bodgit/bkm-129x-ultimate/main/main.kicad_pcb

## KiCad design main/main.kicad_pcb (2022-10-09)

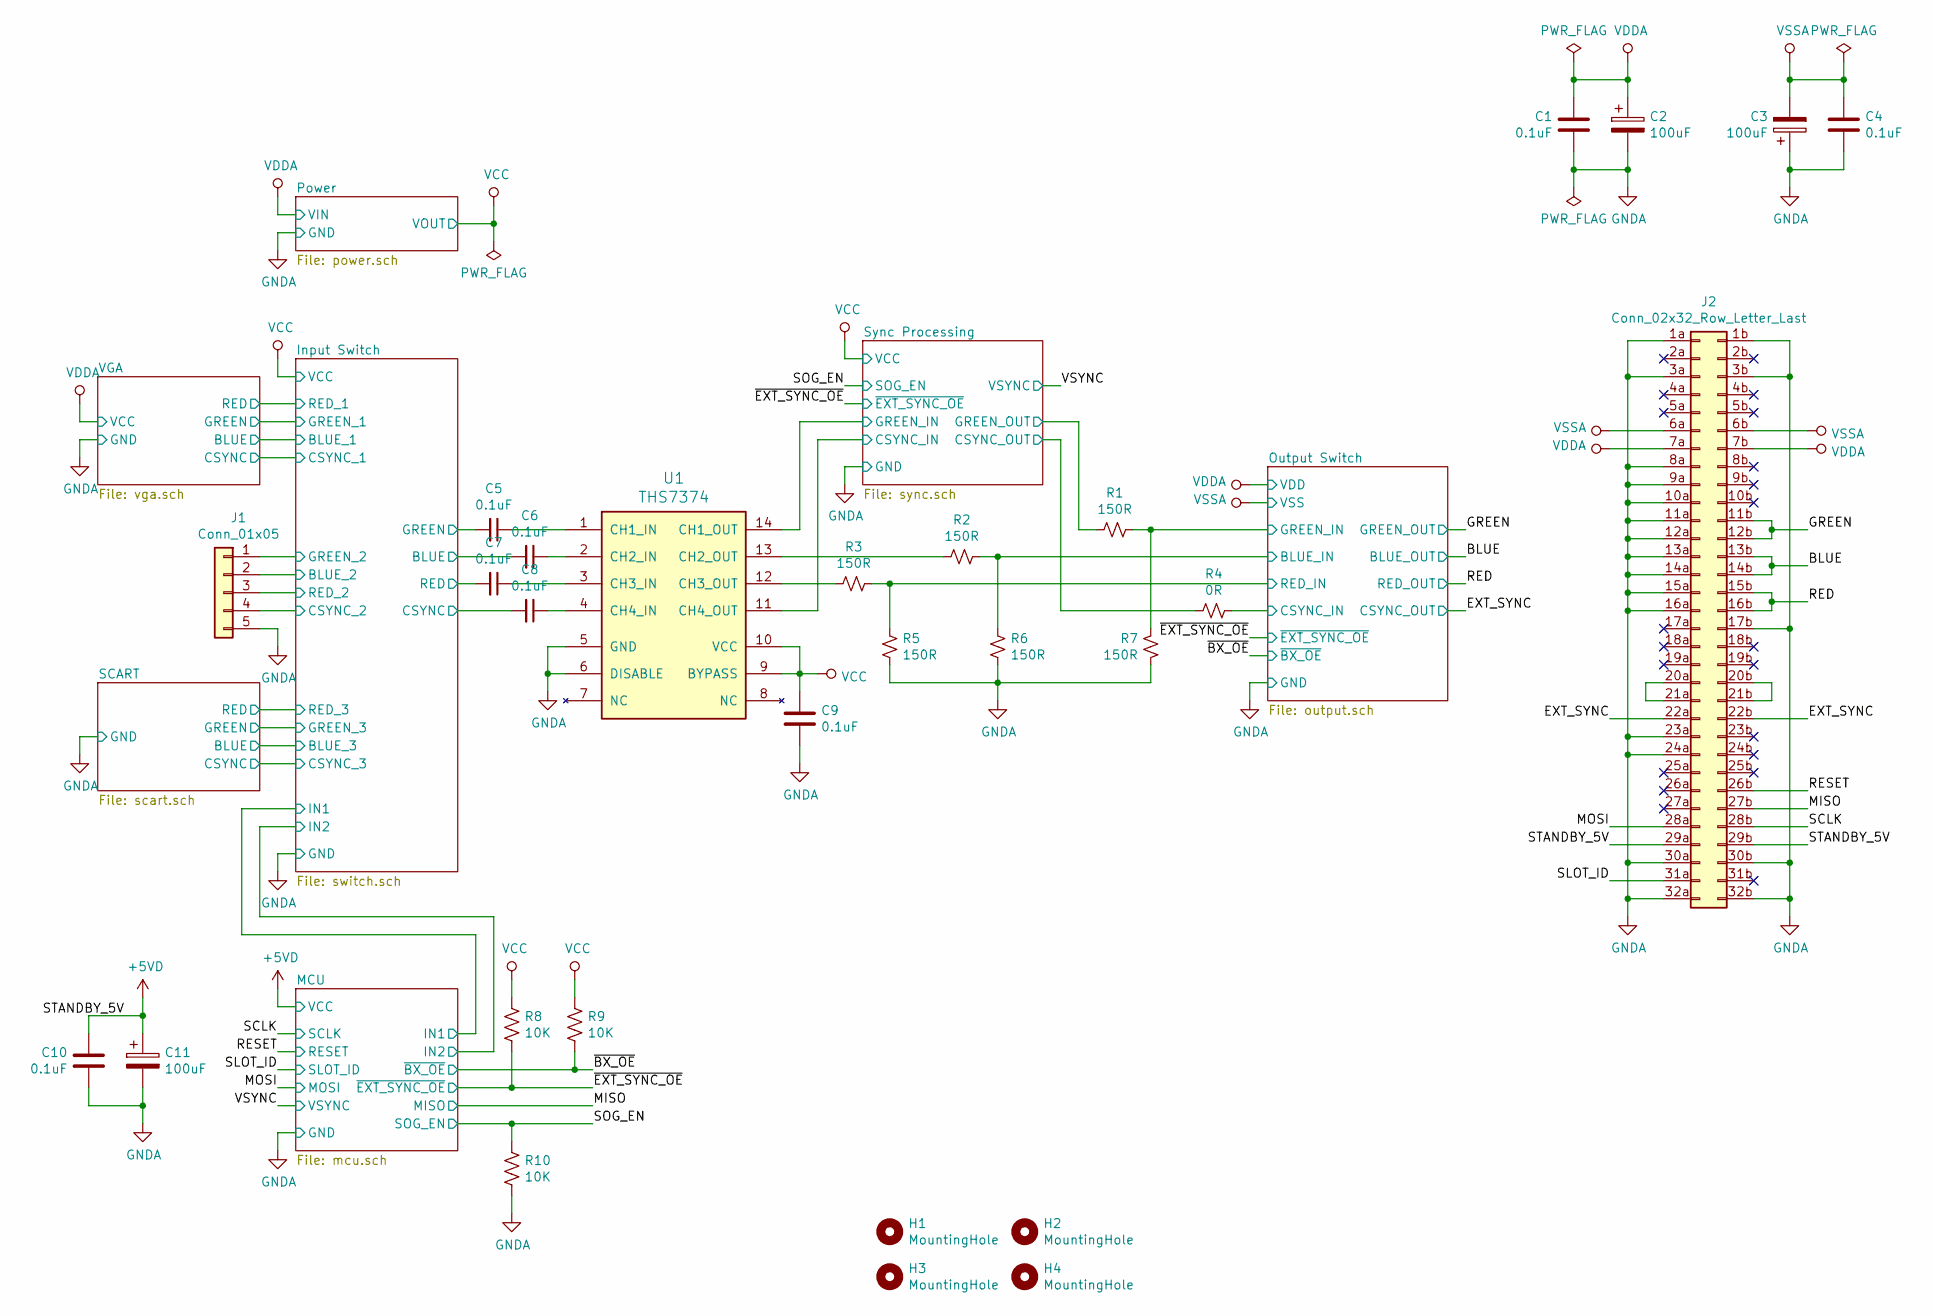
[picture p1: schematic main.sch]

Parts:
C1, C4, C5, C6, C7, C8, C9, C10: 0.1uF; C_0805_2012Metric_Pad1.15x1.40mm_HandSolder
C2, C3, C11: 100uF; CP_Elec_6.3x5.3
H1, H2, H3, H4: MountingHole; MountingHole_3.2mm_M3
J1: Conn_01x05; JST_NH_BS5P-SHF-1AA_1x05_P2.50mm_Horizontal
J2: Conn_02x32_Row_Letter_Last; STANDARD-PIN-64P-RA
R1, R2, R3, R5, R6, R7: 150R; R_0805_2012Metric_Pad1.15x1.40mm_HandSolder
R4: 0R; R_0805_2012Metric_Pad1.15x1.40mm_HandSolder
R8, R9, R10: 10K; R_0805_2012Metric_Pad1.15x1.40mm_HandSolder
U1: THS7374; TSSOP-14_4.4x5mm_P0.65mm

Connections:
+5VD: C10.1, C11.1, J2.29a, J2.29b; also elsewhere on the board
/BLUE: J2.13b, J2.14b; also elsewhere on the board
/EXT_SYNC: J2.22a, J2.22b; also elsewhere on the board
/GREEN: J2.11b, J2.12b; also elsewhere on the board
/Input Switch/BLUE: C6.2; also elsewhere on the board
/Input Switch/BLUE_2: J1.2; also elsewhere on the board
/Input Switch/CSYNC: C8.2; also elsewhere on the board
/Input Switch/CSYNC_2: J1.4; also elsewhere on the board
/Input Switch/GREEN: C5.2; also elsewhere on the board
/Input Switch/GREEN_2: J1.1; also elsewhere on the board
/Input Switch/RED: C7.2; also elsewhere on the board
/Input Switch/RED_2: J1.3; also elsewhere on the board
/MISO: J2.27b; also elsewhere on the board
/MOSI: J2.28a; also elsewhere on the board
/Output Switch/BLUE_IN: R2.1, R6.2; also elsewhere on the board
/Output Switch/CSYNC_IN: R4.1; also elsewhere on the board
/Output Switch/GREEN_IN: R1.1, R7.2; also elsewhere on the board
/Output Switch/RED_IN: R3.1, R5.2; also elsewhere on the board
/RED: J2.15b, J2.16b; also elsewhere on the board
/RESET: J2.26b; also elsewhere on the board
/SCLK: J2.28b; also elsewhere on the board
/SLOT_ID: J2.31a; also elsewhere on the board
/SOG_EN: R10.1; also elsewhere on the board
/Sync Processing/CSYNC_IN: U1.11 (CH4_OUT); also elsewhere on the board
/Sync Processing/CSYNC_OUT: R4.2; also elsewhere on the board
/Sync Processing/GREEN_IN: U1.14 (CH1_OUT); also elsewhere on the board
/Sync Processing/GREEN_OUT: R1.2; also elsewhere on the board
/~BX_OE: R9.2; also elsewhere on the board
/~EXT_SYNC_OE: R8.2; also elsewhere on the board
GND: C1.2, C2.2, C3.1, C4.2, C9.2, C10.2, C11.2, J1.5, J2.1a, J2.1b, J2.3a, J2.3b, J2.8a, J2.9a, J2.10a, J2.11a, J2.12a, J2.13a, J2.14a, J2.15a, J2.16a, J2.17b, J2.23a, J2.24a, J2.30a, J2.30b, J2.32a, J2.32b, R5.1, R6.1, R7.1, R10.2, U1.5 (GND), U1.6 (DISABLE); also elsewhere on the board
unnamed: C5.1, U1.1 (CH1_IN)
unnamed: C6.1, U1.2 (CH2_IN)
unnamed: C7.1, U1.3 (CH3_IN)
unnamed: C8.1, U1.4 (CH4_IN)
unnamed: J2.20a, J2.21a
unnamed: J2.20b, J2.21b
unnamed: R2.2, U1.13 (CH2_OUT)
unnamed: R3.2, U1.12 (CH3_OUT)
VCC: C9.1, R8.1, R9.1, U1.9 (BYPASS), U1.10 (VCC); also elsewhere on the board
VDDA: C1.1, C2.1, J2.7a, J2.7b; also elsewhere on the board
VSSA: C3.2, C4.1, J2.6a, J2.6b; also elsewhere on the board

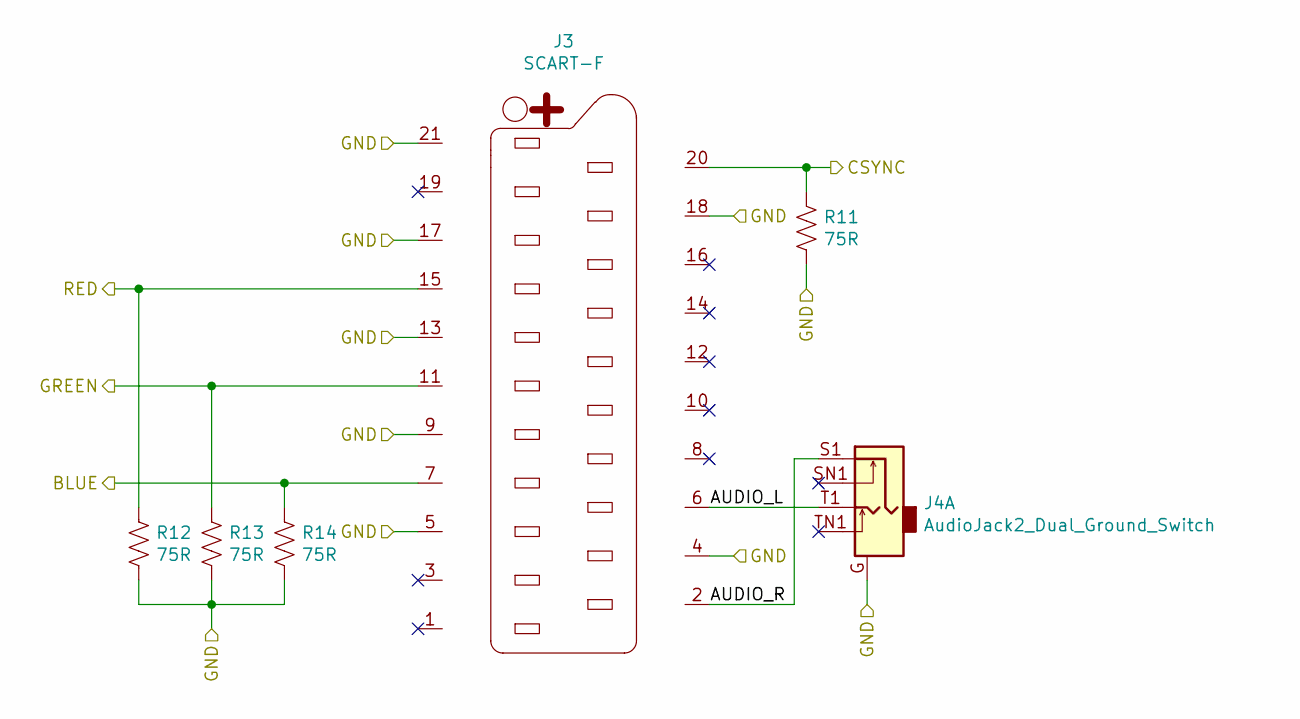
[picture p2: schematic scart.sch]

Parts:
J3: SCART-F; NINIGI-SCART-RA
J4: AudioJack2_Dual_Ground_Switch; SJ1-353XNG
R11, R12, R13, R14: 75R; R_0805_2012Metric_Pad1.15x1.40mm_HandSolder

Connections:
/SCART/AUDIO_L: J3.6, J4.T1
/SCART/AUDIO_R: J3.2, J4.S1
/SCART/BLUE: J3.7, R14.1; also elsewhere on the board
/SCART/CSYNC: J3.20, R11.1; also elsewhere on the board
/SCART/GREEN: J3.11, R13.1; also elsewhere on the board
/SCART/RED: J3.15, R12.1; also elsewhere on the board
GND: J3.4, J3.5, J3.9, J3.13, J3.17, J3.18, J3.21, J4.G, R11.2, R12.2, R13.2, R14.2; also elsewhere on the board

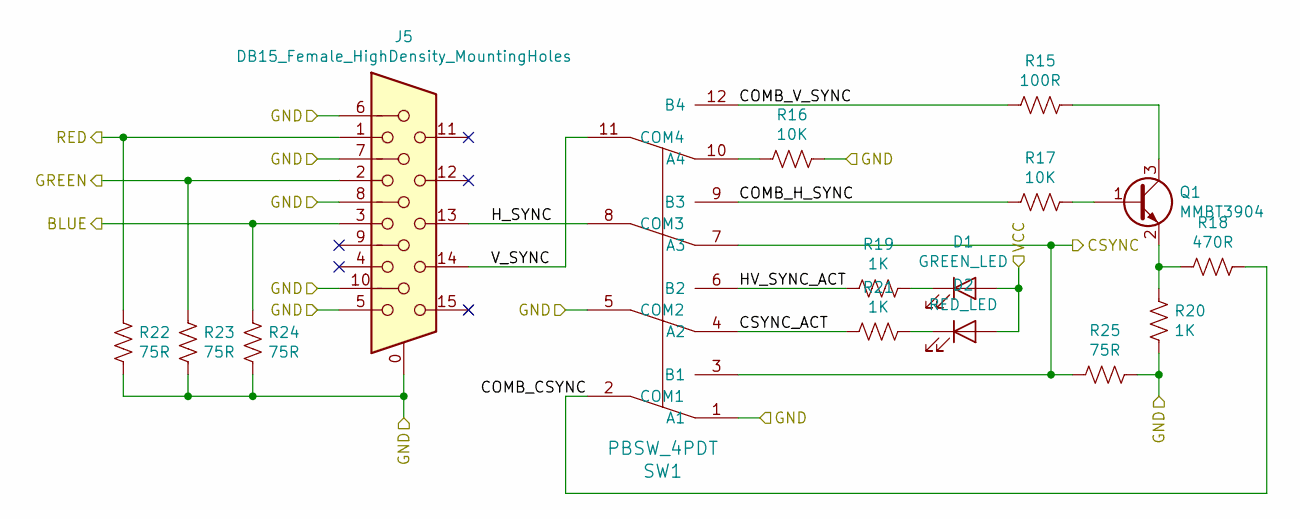
[picture p3: schematic vga.sch]

Parts:
D1: GREEN_LED; D_0805_2012Metric_Pad1.15x1.40mm_HandSolder
D2: RED_LED; D_0805_2012Metric_Pad1.15x1.40mm_HandSolder
J5: DB15_Female_HighDensity_MountingHoles; HD15-VGA
Q1: MMBT3904; SOT-23_Handsoldering
R15: 100R; R_0805_2012Metric_Pad1.15x1.40mm_HandSolder
R16, R17: 10K; R_0805_2012Metric_Pad1.15x1.40mm_HandSolder
R18: 470R; R_0805_2012Metric_Pad1.15x1.40mm_HandSolder
R19, R20, R21: 1K; R_0805_2012Metric_Pad1.15x1.40mm_HandSolder
R22, R23, R24, R25: 75R; R_0805_2012Metric_Pad1.15x1.40mm_HandSolder
SW1: PBSW_4PDT; PBH4U

Connections:
/VGA/BLUE: J5.3, R24.1; also elsewhere on the board
/VGA/COMB_CSYNC: R18.1, SW1.2 (COM1)
/VGA/COMB_H_SYNC: R17.2, SW1.9 (B3)
/VGA/COMB_V_SYNC: R15.2, SW1.12 (B4)
/VGA/CSYNC: R25.2, SW1.3 (B1), SW1.7 (A3); also elsewhere on the board
/VGA/CSYNC_ACT: R21.2, SW1.4 (A2)
/VGA/GREEN: J5.2, R23.1; also elsewhere on the board
/VGA/HV_SYNC_ACT: R19.2, SW1.6 (B2)
/VGA/H_SYNC: J5.13, SW1.8 (COM3)
/VGA/RED: J5.1, R22.1; also elsewhere on the board
/VGA/V_SYNC: J5.14, SW1.11 (COM4)
GND: J5.0, J5.5, J5.6, J5.7, J5.8, J5.10, R16.2, R20.2, R22.2, R23.2, R24.2, R25.1, SW1.1 (A1), SW1.5 (COM2); also elsewhere on the board
unnamed: D1.1 (K), R19.1
unnamed: D2.1 (K), R21.1
unnamed: Q1.1 (B), R17.1
unnamed: Q1.2 (E), R18.2, R20.1
unnamed: Q1.3 (C), R15.1
unnamed: R16.1, SW1.10 (A4)
VDDA: D1.2 (A), D2.2 (A); also elsewhere on the board

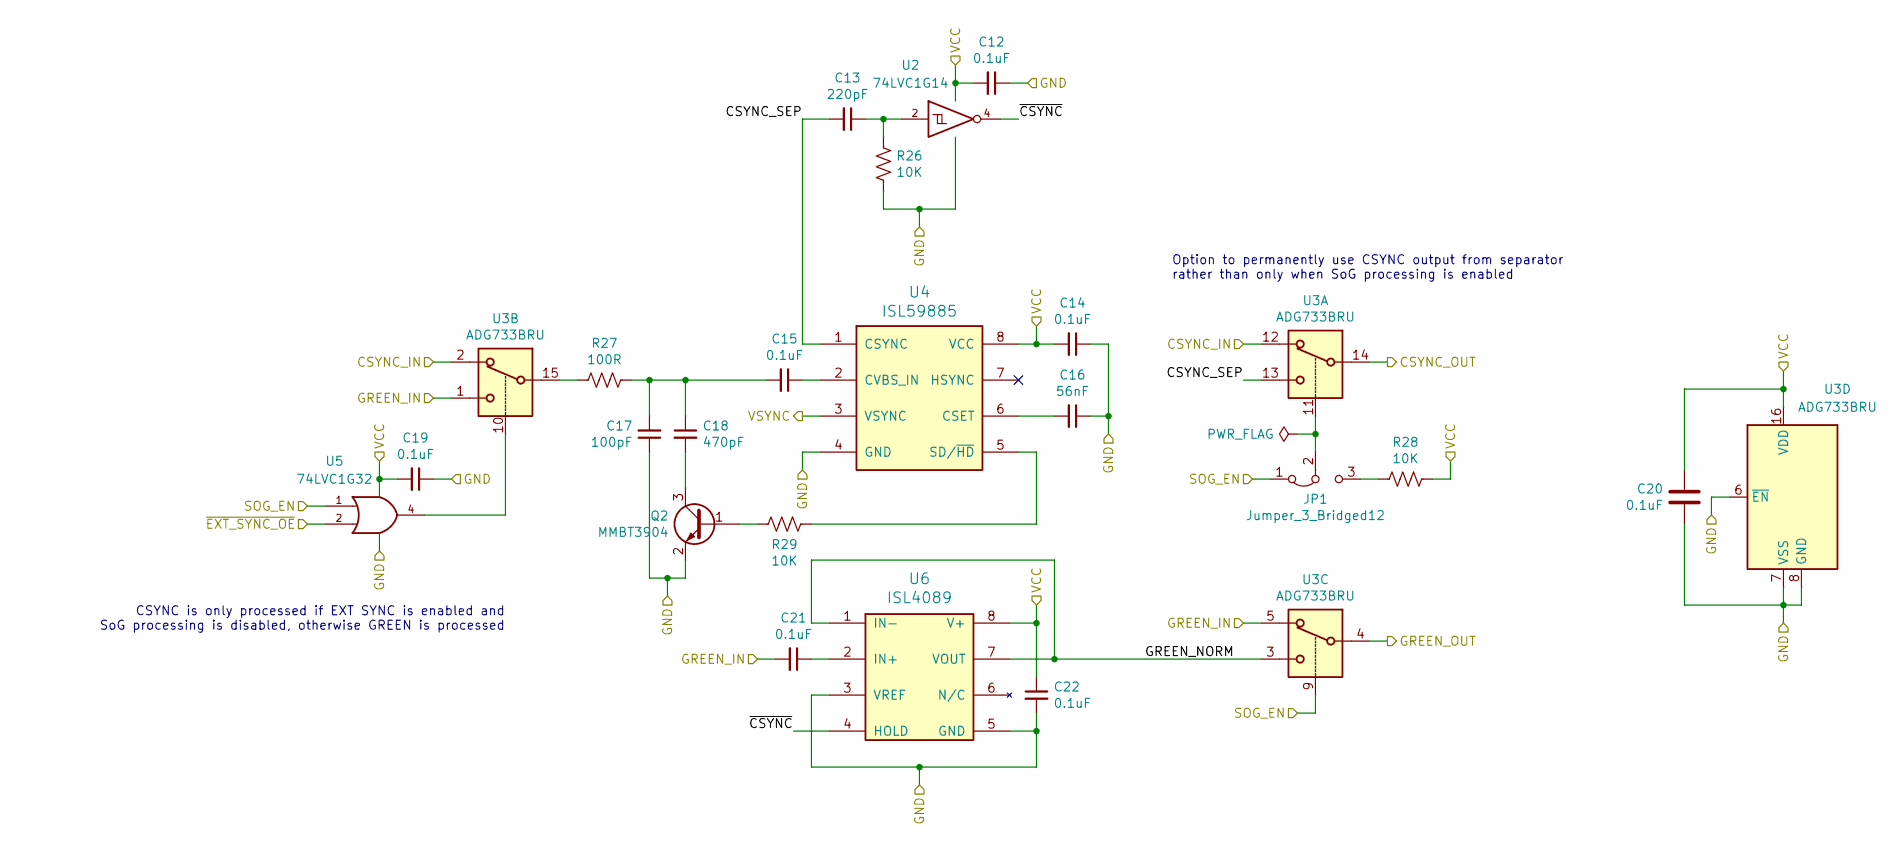
[picture p4: schematic sync.sch]

Parts:
C12, C14, C15, C19, C20, C21, C22: 0.1uF; C_0805_2012Metric_Pad1.15x1.40mm_HandSolder
C13: 220pF; C_0805_2012Metric_Pad1.15x1.40mm_HandSolder
C16: 56nF; C_0805_2012Metric_Pad1.15x1.40mm_HandSolder
C17: 100pF; C_0805_2012Metric_Pad1.15x1.40mm_HandSolder
C18: 470pF; C_0805_2012Metric_Pad1.15x1.40mm_HandSolder
JP1: Jumper_3_Bridged12; PinHeader_1x03_P2.54mm_Vertical
Q2: MMBT3904; SOT-23_Handsoldering
R26, R28, R29: 10K; R_0805_2012Metric_Pad1.15x1.40mm_HandSolder
R27: 100R; R_0805_2012Metric_Pad1.15x1.40mm_HandSolder
U2: 74LVC1G14; SOT-23-5_HandSoldering
U3: ADG733BRU; TSSOP-16_4.4x5mm_P0.65mm
U4: ISL59885; SOIC-8_3.9x4.9mm_P1.27mm
U5: 74LVC1G32; SOT-23-5_HandSoldering
U6: ISL4089; SOIC-8_3.9x4.9mm_P1.27mm

Connections:
/SOG_EN: JP1.1 (A), U3.9, U5.1; also elsewhere on the board
/Sync Processing/CSYNC_IN: U3.2, U3.12; also elsewhere on the board
/Sync Processing/CSYNC_OUT: U3.14; also elsewhere on the board
/Sync Processing/CSYNC_SEP: C13.2, U3.13, U4.1 (CSYNC)
/Sync Processing/GREEN_IN: C21.2, U3.1, U3.5; also elsewhere on the board
/Sync Processing/GREEN_NORM: U3.3, U6.1 (IN-), U6.7 (VOUT)
/Sync Processing/GREEN_OUT: U3.4; also elsewhere on the board
/Sync Processing/~CSYNC: U2.4, U6.4 (HOLD)
/VSYNC: U4.3 (VSYNC); also elsewhere on the board
/~EXT_SYNC_OE: U5.2; also elsewhere on the board
GND: C12.1, C14.1, C16.1, C17.1, C19.1, C20.2, C22.2, Q2.2 (E), R26.2, U2.3 (GND), U3.6 (~EN), U3.7 (VSS), U3.8 (GND), U4.4 (GND), U5.3 (GND), U6.3 (VREF), U6.5 (GND); also elsewhere on the board
unnamed: C13.1, R26.1, U2.2
unnamed: C15.1, U4.2 (CVBS_IN)
unnamed: C15.2, C17.2, C18.1, R27.1
unnamed: C16.2, U4.6 (CSET)
unnamed: C18.2, Q2.3 (C)
unnamed: C21.1, U6.2 (IN+)
unnamed: JP1.2 (C), U3.11
unnamed: JP1.3 (B), R28.2
unnamed: Q2.1 (B), R29.2
unnamed: R27.2, U3.15
unnamed: R29.1, U4.5 (SD/~HD)
unnamed: U3.10, U5.4
VCC: C12.2, C14.2, C19.2, C20.1, C22.1, R28.1, U2.5 (VCC), U3.16 (VDD), U4.8 (VCC), U5.5 (VCC), U6.8 (V+); also elsewhere on the board

Notes on the sheet:
CSYNC is only processed if EXT SYNC is enabled and SoG processing is disabled, otherwise GREEN is processed
Option to permanently use CSYNC output from separator rather than only when SoG processing is enabled

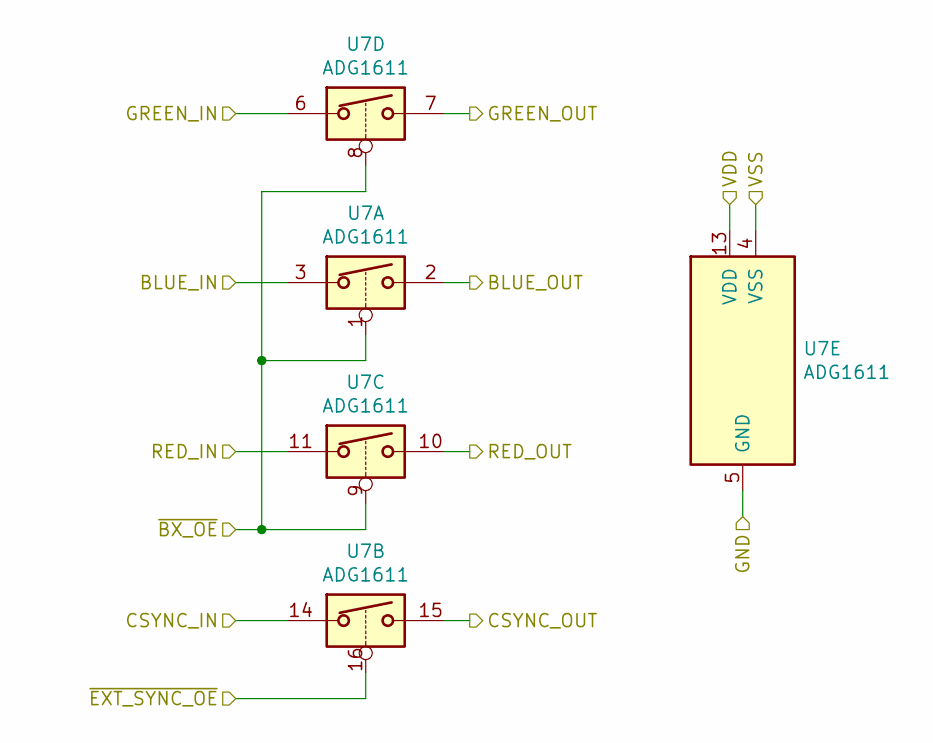
[picture p5: schematic output.sch]

Parts:
U7: ADG1611; TSSOP-16_4.4x5mm_P0.65mm

Connections:
/BLUE: U7.2; also elsewhere on the board
/EXT_SYNC: U7.15; also elsewhere on the board
/GREEN: U7.7; also elsewhere on the board
/Output Switch/BLUE_IN: U7.3; also elsewhere on the board
/Output Switch/CSYNC_IN: U7.14; also elsewhere on the board
/Output Switch/GREEN_IN: U7.6; also elsewhere on the board
/Output Switch/RED_IN: U7.11; also elsewhere on the board
/RED: U7.10; also elsewhere on the board
/~BX_OE: U7.1, U7.8, U7.9; also elsewhere on the board
/~EXT_SYNC_OE: U7.16; also elsewhere on the board
GND: U7.5 (GND); also elsewhere on the board
VDDA: U7.13 (VDD); also elsewhere on the board
VSSA: U7.4 (VSS); also elsewhere on the board

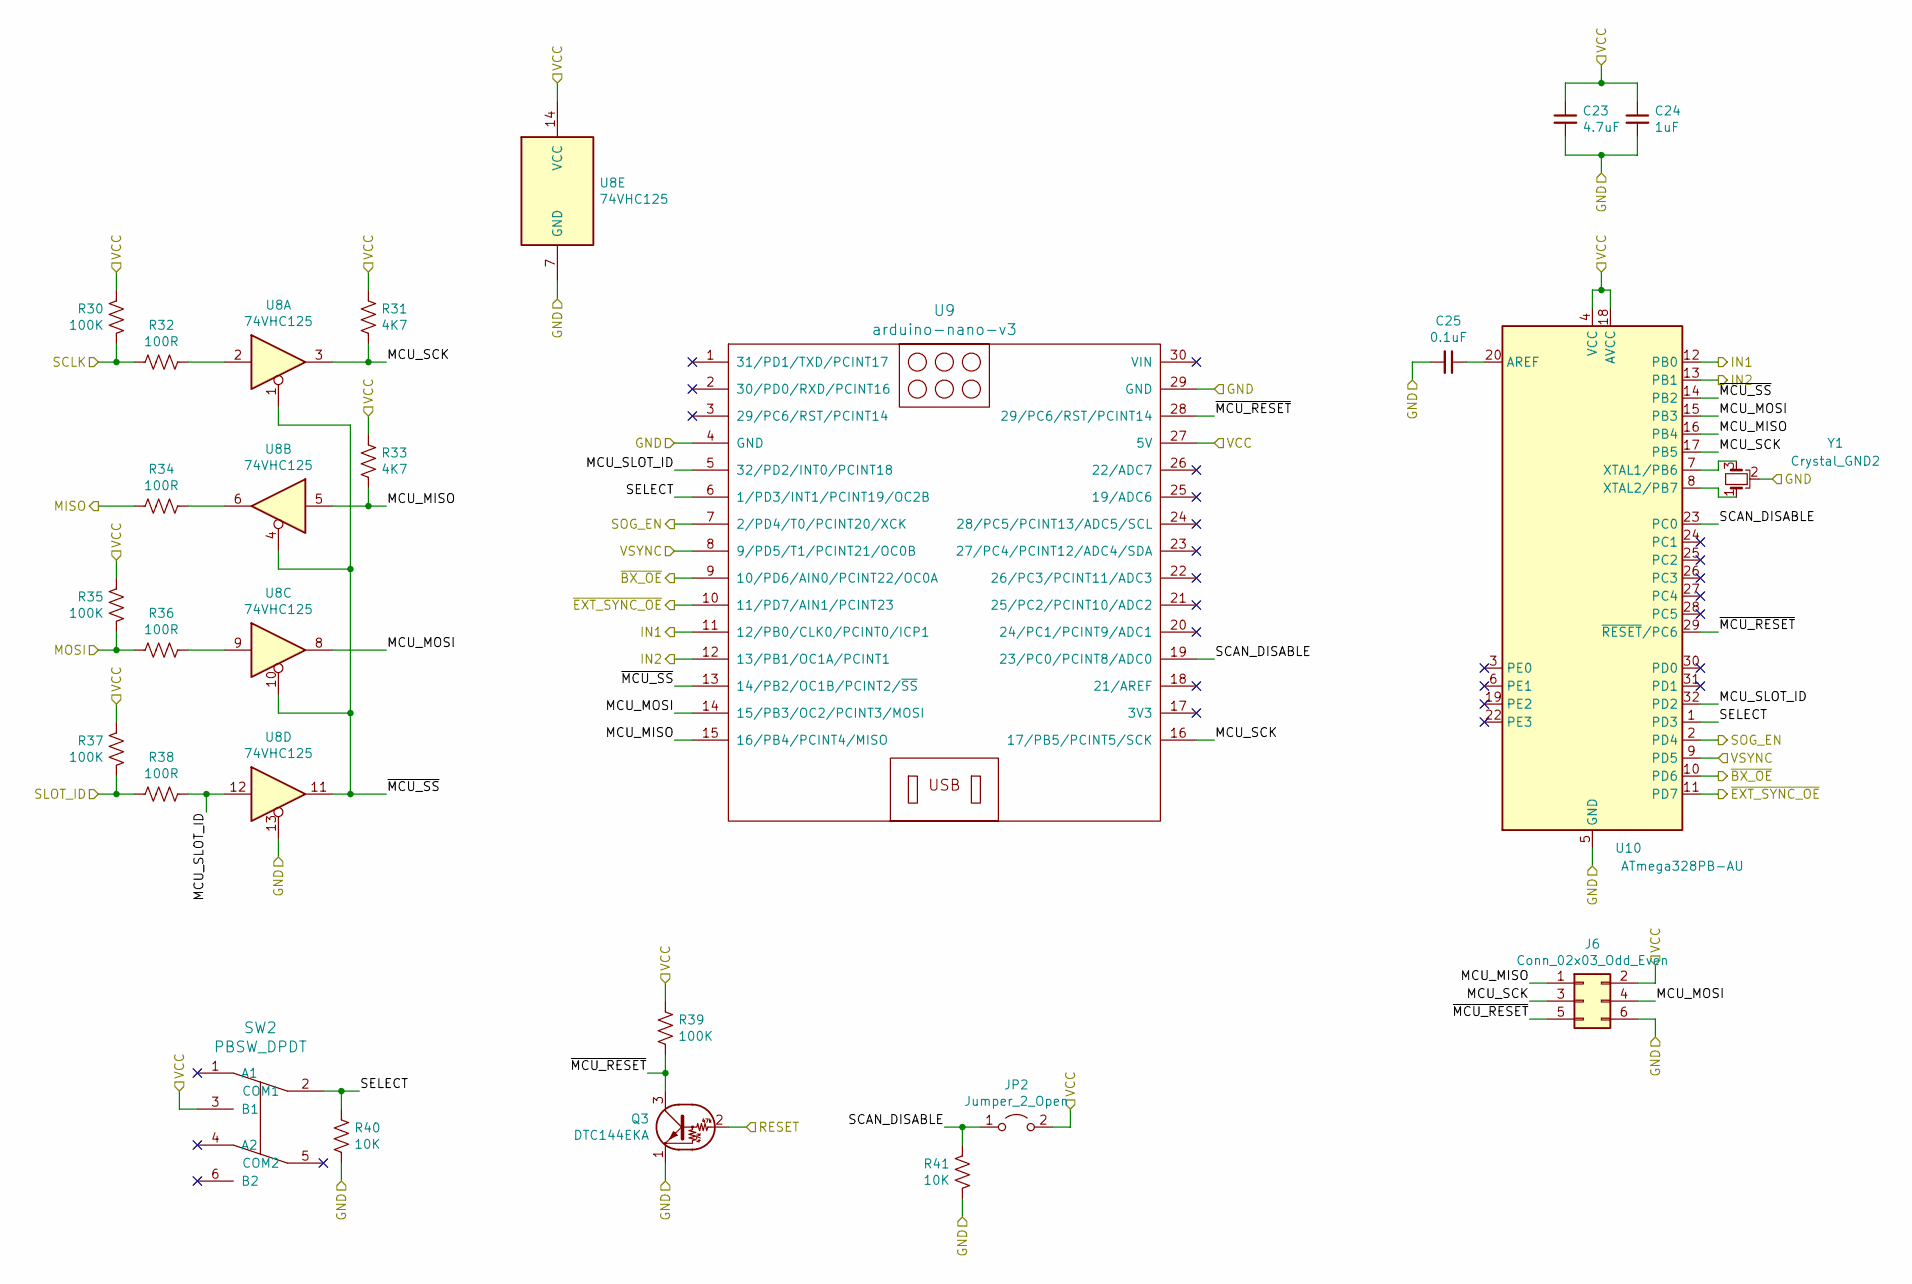
[picture p6: schematic mcu.sch]

Parts:
C23: 4.7uF; C_0805_2012Metric_Pad1.15x1.40mm_HandSolder
C24: 1uF; C_0805_2012Metric_Pad1.15x1.40mm_HandSolder
C25: 0.1uF; C_0805_2012Metric_Pad1.15x1.40mm_HandSolder
J6: Conn_02x03_Odd_Even; PinHeader_2x03_P2.54mm_Vertical
JP2: Jumper_2_Open; PinHeader_1x02_P2.54mm_Vertical
Q3: DTC144EKA; SC-59_Handsoldering
R30, R35, R37, R39: 100K; R_0805_2012Metric_Pad1.15x1.40mm_HandSolder
R31, R33: 4K7; R_0805_2012Metric_Pad1.15x1.40mm_HandSolder
R32, R34, R36, R38: 100R; R_0805_2012Metric_Pad1.15x1.40mm_HandSolder
R40, R41: 10K; R_0805_2012Metric_Pad1.15x1.40mm_HandSolder
SW2: PBSW_DPDT; PBH2U
U8: 74VHC125; TSSOP-14_4.4x5mm_P0.65mm
U9: arduino-nano-v3
U10: ATmega328PB-AU; TQFP-32_7x7mm_P0.8mm
Y1: Crystal_GND2; Resonator_SMD_muRata_CSTxExxV-3Pin_3.0x1.1mm

Connections:
+5VD: C23.1, C24.1, J6.2, JP2.2 (B), R30.2, R31.1, R33.1, R35.2, R37.2, R39.1, SW2.3 (B1), U8.14 (VCC), U9.27 (5V), U10.4 (VCC), U10.18 (AVCC); also elsewhere on the board
/Input Switch/IN1: U9.11 (12/PB0/CLK0/PCINT0/ICP1), U10.12 (PB0); also elsewhere on the board
/Input Switch/IN2: U9.12 (13/PB1/OC1A/PCINT1), U10.13 (PB1); also elsewhere on the board
/MCU/MCU_MISO: J6.1, R33.2, U8.5, U9.15 (16/PB4/PCINT4/MISO), U10.16 (PB4)
/MCU/MCU_MOSI: J6.4, U8.8, U9.14 (15/PB3/OC2/PCINT3/MOSI), U10.15 (PB3)
/MCU/MCU_SCK: J6.3, R31.2, U8.3, U9.16 (17/PB5/PCINT5/SCK), U10.17 (PB5)
/MCU/MCU_SLOT_ID: R38.1, U8.12, U9.5 (32/PD2/INT0/PCINT18), U10.32 (PD2)
/MCU/SCAN_DISABLE: JP2.1 (A), R41.2, U9.19 (23/PC0/PCINT8/ADC0), U10.23 (PC0)
/MCU/SELECT: R40.1, SW2.2 (COM1), U9.6 (1/PD3/INT1/PCINT19/OC2B), U10.1 (PD3)
/MCU/~MCU_RESET: J6.5, Q3.3 (C), R39.2, U9.28 (29/PC6/RST/PCINT14), U10.29 (~RESET~/PC6)
/MCU/~MCU_SS: U8.1, U8.4, U8.10, U8.11, U9.13 (14/PB2/OC1B/PCINT2/~SS), U10.14 (PB2)
/MISO: R34.2; also elsewhere on the board
/MOSI: R35.1, R36.2; also elsewhere on the board
/RESET: Q3.2 (B); also elsewhere on the board
/SCLK: R30.1, R32.2; also elsewhere on the board
/SLOT_ID: R37.1, R38.2; also elsewhere on the board
/SOG_EN: U9.7 (2/PD4/T0/PCINT20/XCK), U10.2 (PD4); also elsewhere on the board
/VSYNC: U9.8 (9/PD5/T1/PCINT21/OC0B), U10.9 (PD5); also elsewhere on the board
/~BX_OE: U9.9 (10/PD6/AIN0/PCINT22/OC0A), U10.10 (PD6); also elsewhere on the board
/~EXT_SYNC_OE: U9.10 (11/PD7/AIN1/PCINT23), U10.11 (PD7); also elsewhere on the board
GND: C23.2, C24.2, C25.2, J6.6, Q3.1 (E), R40.2, R41.1, U8.7 (GND), U8.13, U9.4 (GND), U9.29 (GND), U10.5 (GND), U10.21 (GND), Y1.2; also elsewhere on the board
unnamed: C25.1, U10.20 (AREF)
unnamed: R32.1, U8.2
unnamed: R34.1, U8.6
unnamed: R36.1, U8.9
unnamed: U10.7 (XTAL1/PB6), Y1.3
unnamed: U10.8 (XTAL2/PB7), Y1.1

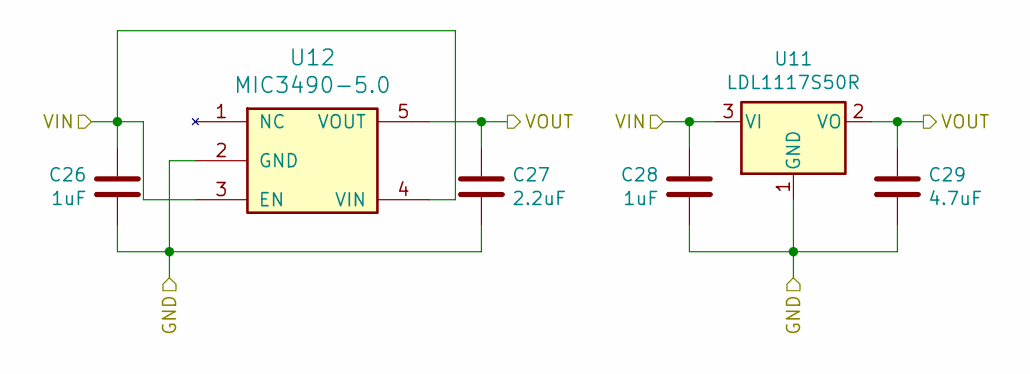
[picture p7: schematic power.sch]

Parts:
C26, C28: 1uF; C_0805_2012Metric_Pad1.15x1.40mm_HandSolder
C27: 2.2uF; C_0805_2012Metric_Pad1.15x1.40mm_HandSolder
C29: 4.7uF; C_0805_2012Metric_Pad1.15x1.40mm_HandSolder
U11: LDL1117S50R; SOT-223-3_TabPin2
U12: MIC3490-5.0; SOT-23-5_HandSoldering

Connections:
GND: C26.1, C27.2, C28.1, C29.2, U11.1 (GND), U12.2 (GND); also elsewhere on the board
VCC: C27.1, C29.1, U11.2 (VO), U12.5 (VOUT); also elsewhere on the board
VDDA: C26.2, C28.2, U11.3 (VI), U12.3 (EN), U12.4 (VIN); also elsewhere on the board

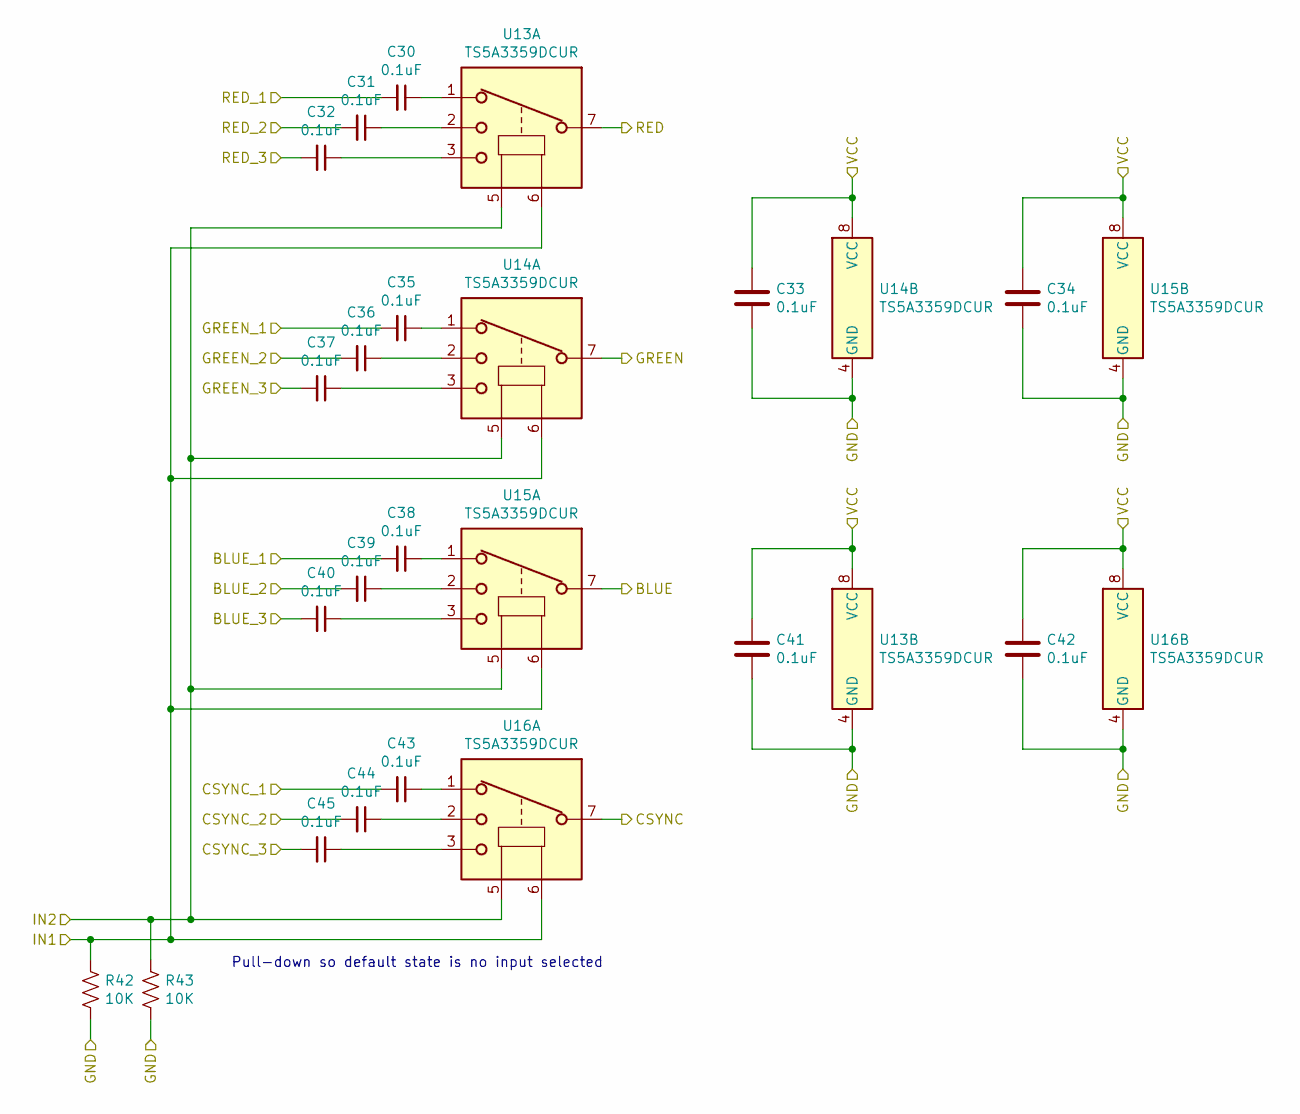
[picture p8: schematic switch.sch]

Parts:
C30, C31, C32, C33, C34, C35, C36, C37, C38, C39, C40, C41, C42, C43, C44, C45: 0.1uF; C_0805_2012Metric_Pad1.15x1.40mm_HandSolder
R42, R43: 10K; R_0805_2012Metric_Pad1.15x1.40mm_HandSolder
U13, U14, U15, U16: TS5A3359DCUR; VSSOP-8_2.3x2mm_P0.5mm

Connections:
/Input Switch/BLUE: U15.7; also elsewhere on the board
/Input Switch/BLUE_2: C39.2; also elsewhere on the board
/Input Switch/CSYNC: U16.7; also elsewhere on the board
/Input Switch/CSYNC_2: C44.2; also elsewhere on the board
/Input Switch/GREEN: U14.7; also elsewhere on the board
/Input Switch/GREEN_2: C36.2; also elsewhere on the board
/Input Switch/IN1: R42.1, U13.6, U14.6, U15.6, U16.6; also elsewhere on the board
/Input Switch/IN2: R43.1, U13.5, U14.5, U15.5, U16.5; also elsewhere on the board
/Input Switch/RED: U13.7; also elsewhere on the board
/Input Switch/RED_2: C31.2; also elsewhere on the board
/SCART/BLUE: C40.2; also elsewhere on the board
/SCART/CSYNC: C45.2; also elsewhere on the board
/SCART/GREEN: C37.2; also elsewhere on the board
/SCART/RED: C32.2; also elsewhere on the board
/VGA/BLUE: C38.2; also elsewhere on the board
/VGA/CSYNC: C43.2; also elsewhere on the board
/VGA/GREEN: C35.2; also elsewhere on the board
/VGA/RED: C30.2; also elsewhere on the board
GND: C33.2, C34.2, C41.2, C42.2, R42.2, R43.2, U13.4 (GND), U14.4 (GND), U15.4 (GND), U16.4 (GND); also elsewhere on the board
unnamed: C30.1, U13.1
unnamed: C31.1, U13.2
unnamed: C32.1, U13.3
unnamed: C35.1, U14.1
unnamed: C36.1, U14.2
unnamed: C37.1, U14.3
unnamed: C38.1, U15.1
unnamed: C39.1, U15.2
unnamed: C40.1, U15.3
unnamed: C43.1, U16.1
unnamed: C44.1, U16.2
unnamed: C45.1, U16.3
VCC: C33.1, C34.1, C41.1, C42.1, U13.8 (VCC), U14.8 (VCC), U15.8 (VCC), U16.8 (VCC); also elsewhere on the board

Notes on the sheet:
Pull-down so default state is no input selected

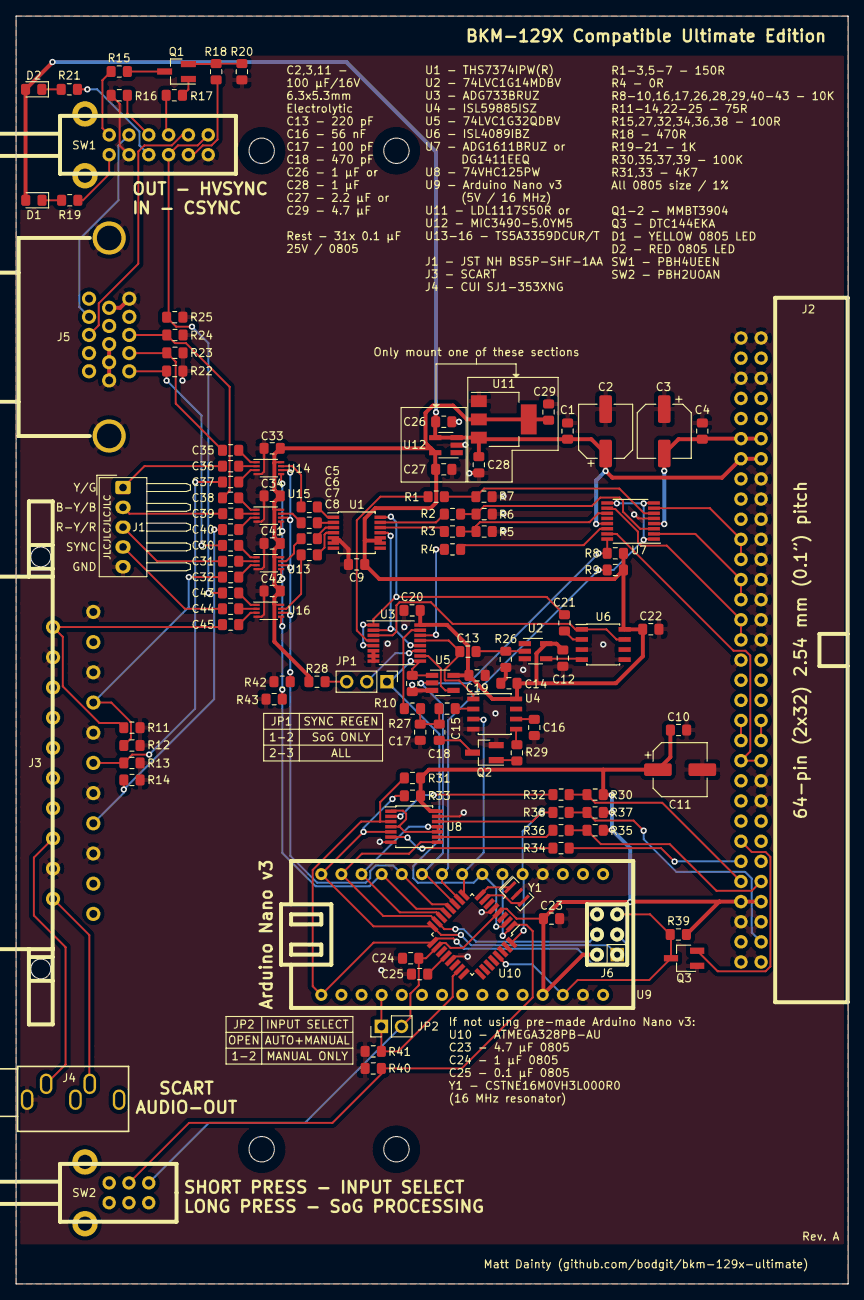
[picture p9: board main.kicad_pcb from above]

Board: 2 copper layers, 105.0 x 160.0 mm, 124 parts (0 on the bottom side), 108 nets.
