bodgit/bkm-129x-ultimate/sub/sub.kicad_pcb

## KiCad design sub/sub.kicad_pcb (2022-10-09)

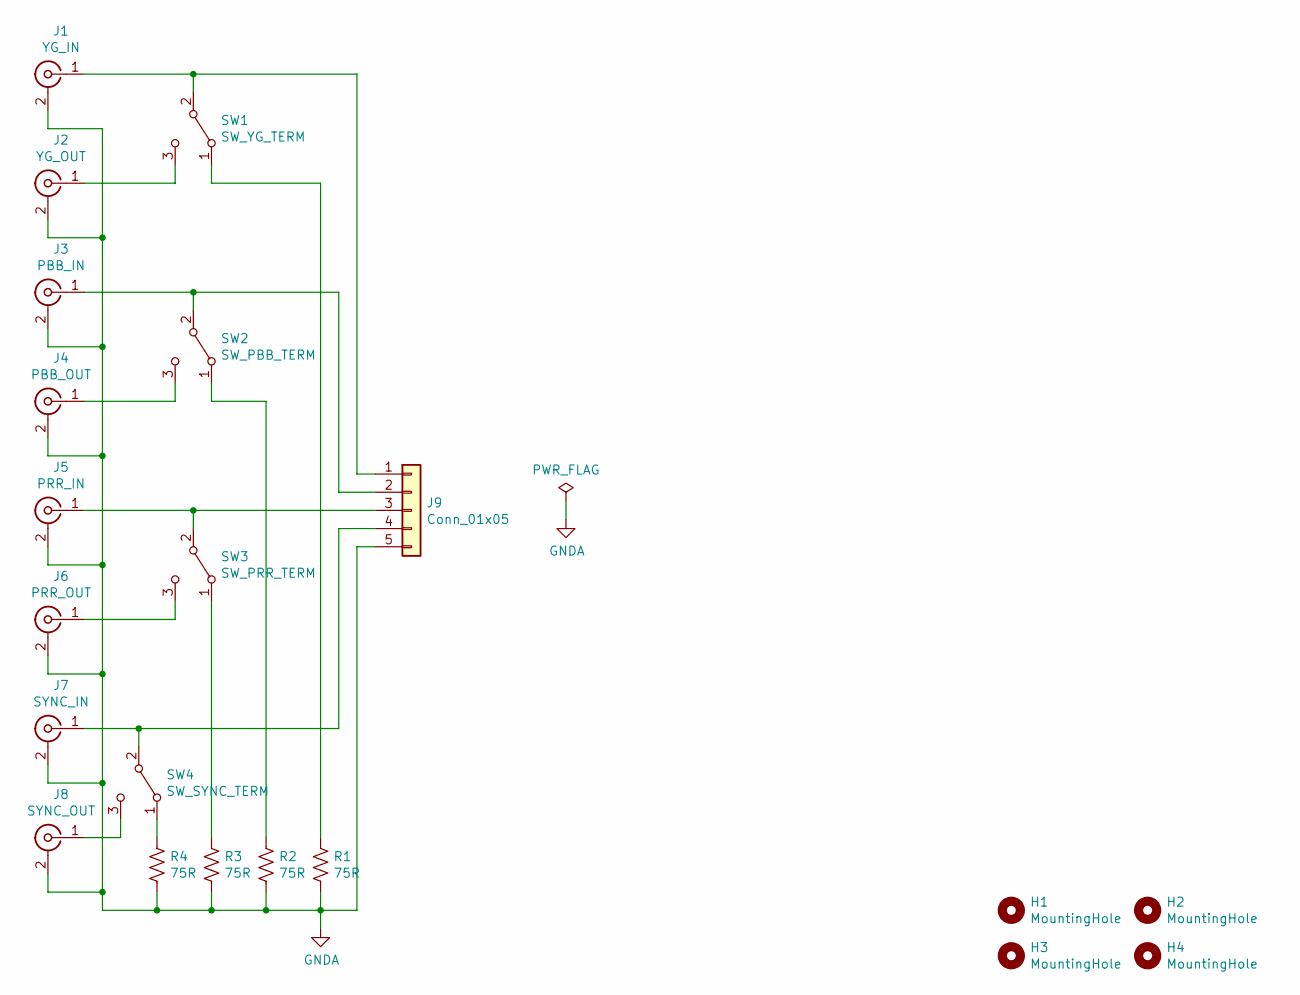
[picture p10: schematic sub.sch]

Parts:
H1, H2, H3, H4: MountingHole; MountingHole_3.2mm_M3
J1: YG_IN; BNC-THT
J2: YG_OUT; BNC-THT
J3: PBB_IN; BNC-THT
J4: PBB_OUT; BNC-THT
J5: PRR_IN; BNC-THT
J6: PRR_OUT; BNC-THT
J7: SYNC_IN; BNC-THT
J8: SYNC_OUT; BNC-THT
J9: Conn_01x05; JST_NH_BS5P-SHF-1AA_1x05_P2.50mm_Horizontal
R1, R2, R3, R4: 75R; R_0805_2012Metric_Pad1.15x1.40mm_HandSolder
SW1: SW_YG_TERM; js202011scqn
SW2: SW_PBB_TERM; js202011scqn
SW3: SW_PRR_TERM; js202011scqn
SW4: SW_SYNC_TERM; js202011scqn

Connections:
GNDA: J1.2 (Ext), J2.2 (Ext), J3.2 (Ext), J4.2 (Ext), J5.2 (Ext), J6.2 (Ext), J7.2 (Ext), J8.2 (Ext), J9.5, R1.2, R2.2, R3.2, R4.2
unnamed: J1.1 (In), J9.1, SW1.2 (B)
unnamed: J2.1 (In), SW1.3 (C)
unnamed: J3.1 (In), J9.2, SW2.2 (B)
unnamed: J4.1 (In), SW2.3 (C)
unnamed: J5.1 (In), J9.3, SW3.2 (B)
unnamed: J6.1 (In), SW3.3 (C)
unnamed: J7.1 (In), J9.4, SW4.2 (B)
unnamed: J8.1 (In), SW4.3 (C)
unnamed: R1.1, SW1.1 (A)
unnamed: R2.1, SW2.1 (A)
unnamed: R3.1, SW3.1 (A)
unnamed: R4.1, SW4.1 (A)

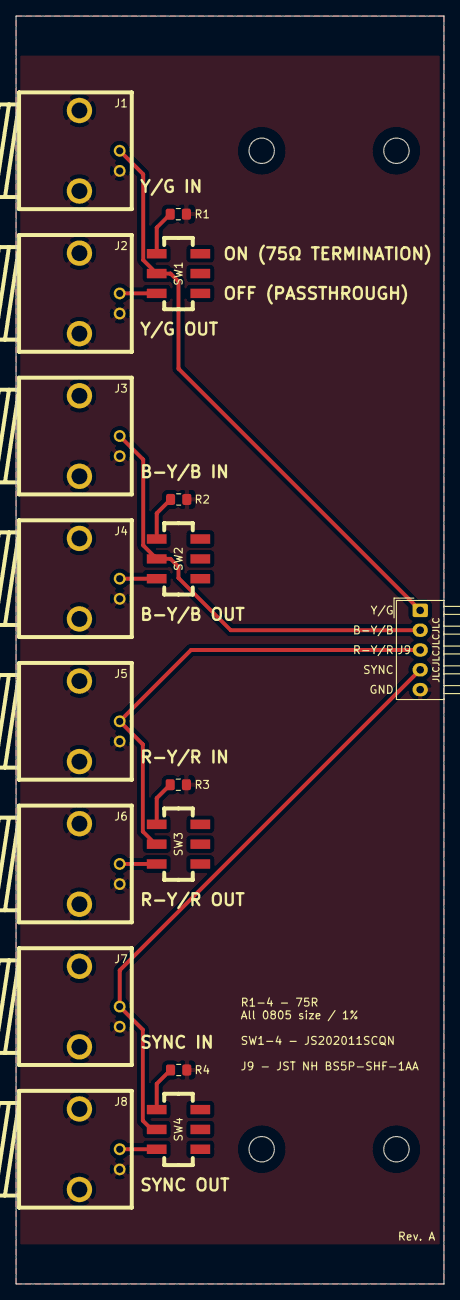
[picture p11: board sub.kicad_pcb from above]

Board: 2 copper layers, 54.0 x 160.0 mm, 21 parts (0 on the bottom side), 13 nets.
