bodgit/bkm-129x-ultimate/(commit log)

2022-10-05 Add main PCB
    Also some minor tweaks.
    [main.kicad_pcb, main.sch, mcu.sch, sub.kicad_pcb]
2022-10-08 Add initial KiBot workflow
    [main.kicad_pcb, scart.sch, sub.sch, vga.sch]
2022-10-09 Use proper mounting holes rather than edge cuts
    [main.kicad_pcb, main.sch, sub.kicad_pcb, sub.sch]
2022-10-09 Change 74LVC125 to 74VHC125
    This particular LVC part can't be used with a 5V supply. The single gate
    LVC parts used elsewhere are fine.
    [mcu.sch]
2022-10-09 Cool kids give credit
    [main.kicad_pcb]
2022-10-09 Add Arduino workflow steps
2022-10-09 Generate bottom silkscreen gerber
2022-12-19 Add OpenSCAD bracket model
    Generate `.stl` file for tags and add to release.
    [bracket.scad]
